smh53/SwarmDetector/README.md

# SwarmDetector

Arı kovanlarında oğul vermeyi, oğul verme sırasında kovanda meydana gelen fiziksel değişikliklerden olan ani sıcaklık artışı ve ani ağırlık düşüşünden tespit edip istenen telefona SMS olarak haber veren Arduino bazlı projedir

# UYARI
Döküman projenin eski versiyonuna ait dökümandır. Projenin tamamlanmış halinin dökümanı değildir.
